pal-lab-cmd/UPS-monitor/README.sch.md

ВАЖЛИВО!

INA3221 проапгрейджена, до силових контактів допаяні шунти опором R010 в паралель до заводських.
Це потрібно зробить, щоб забезпечити 100Вт максимальної потужності на виході

IMPORTANT!

INA3221 has been customized. The shunts were updated, added R010 shunts in parallel to existing.
It is required for high powered device with 100W poer output.
