pal-lab-cmd/UPS-monitor/SCH_UPS_monitor_2026-08-25.png

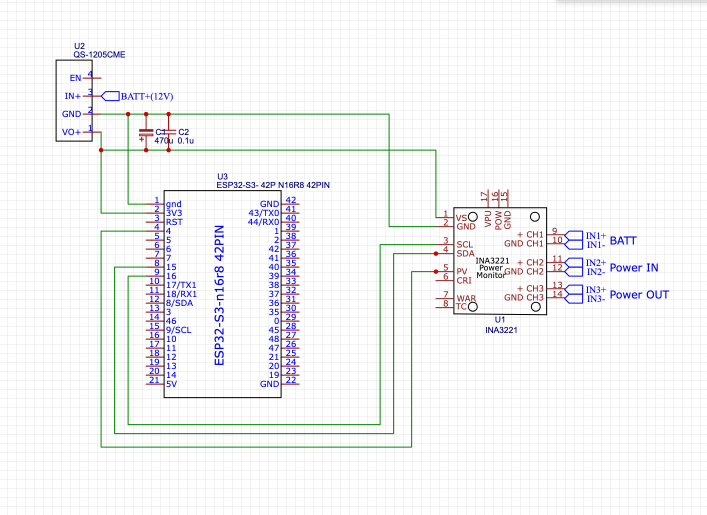
SCH_UPS_monitor_2026-08-25.png
