pal-lab-cmd/UPS-monitor/Screenshot-Charts.png

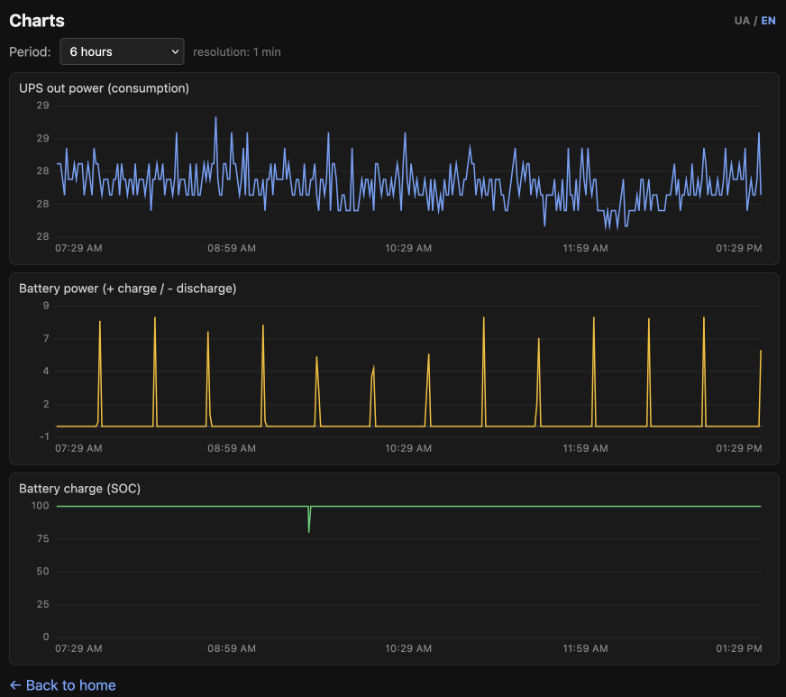
Screenshot-Charts.png
