pal-lab-cmd/UPS-monitor/Screenshot-Homepage.png

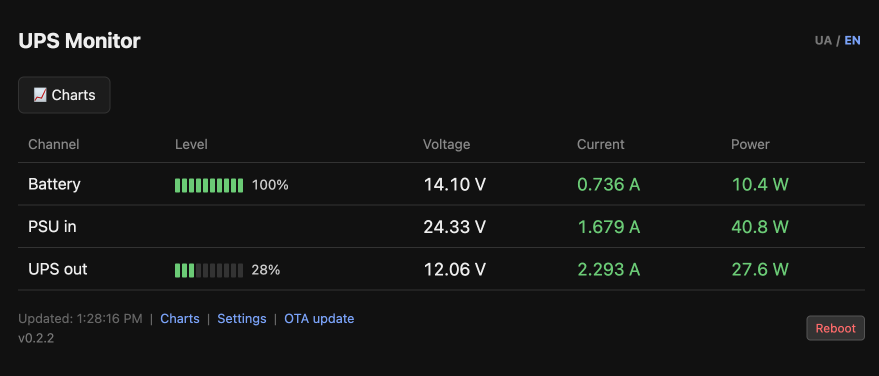
Screenshot-Homepage.png
