pal-lab-cmd/UPS-monitor/Screenshot-OTA-Update.png

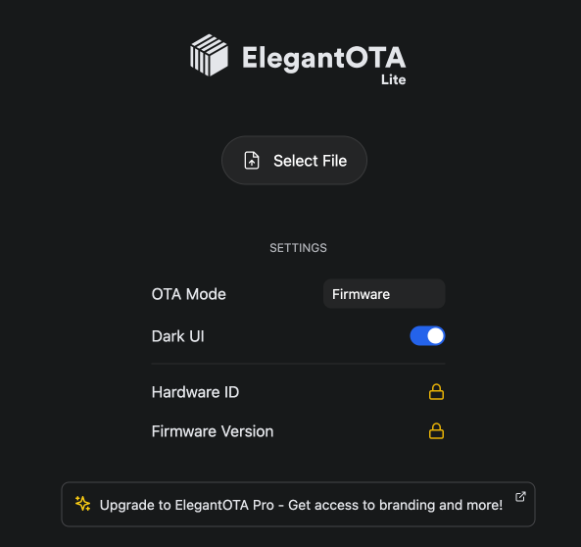
Screenshot-OTA-Update.png
