pal-lab-cmd/UPS-monitor/Screenshot-Settings.png

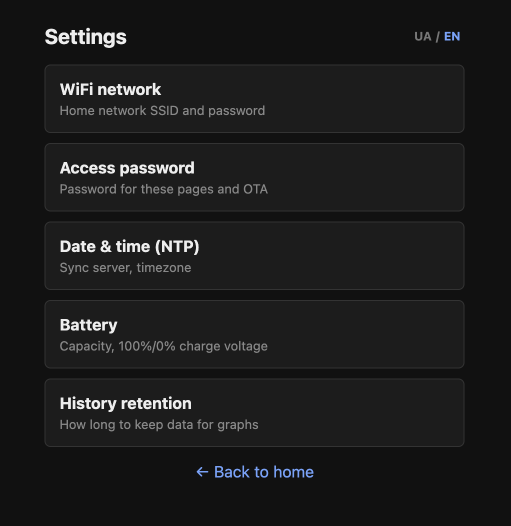
Screenshot-Settings.png
