pal-lab-cmd/UPS-monitor/(list of files, drawings)

Other design files:
UPS_Monitor/schema/SCH_UPS_monitor_2026-08-25.json
