pal-lab-cmd/UPS-monitor/(commit log)

2026-08-24 code for calibrate INO3221
2026-08-24 enable wifi; fixes for build in Arduino IDE; add OTA; add schema
    [SCH_UPS_monitor_2026-08-25.json]
2026-08-24 fix INA3221 channels names
    [config.h]
2026-08-25 multiple fixes: add wifi reconnect; add password protection for settings and OTA pages; add password change in UI; fix potencial crach in api-data
    [UPS_Monitor.ino, config.h, ina3221.h]
2026-08-25 add power in watts to the main page
2026-08-25 add NUT server; update README
2026-08-25 add schematic diagram
2026-08-25 fix schematic diagram in EasyEDA format
    [SCH_UPS_monitor_2026-08-25.json]
2026-08-26 fix multiple bugs; update NUT; use coulomb meter; update READMEs
    [UPS_Monitor.ino, config.h, ina3221.h, nut_server.h]
2026-08-26 implement custom NUT for QNAP
2026-08-26 fix custom NUT for QNAP, it works now
    [config.h, nut_server.h]
2026-08-26 add color indicator for battery and load levels
2026-08-27 add sleep mode for ESP32
2026-08-27 add sleep mode for ESP32 (missed files)
    [sleep.h]
2026-08-27 fix for graphs drawing
    [config.h, history.h]
2026-08-27 final fix for graphs drawing
    [config.h, history.h]
